irsan1805/projectGate-TLab-UMY/BOM Projek Magang TLab.xlsx

Sheet: gate
No. | Category | Name of Item | Spesification | Picture of Product | Link Marketplace | Quantity | Unit Price | Total Cost
1. | Power Supply | Hi-Link HLK-PM01 Modul Power Supply | Input AC 100-220V Output DC 5V 3W |  | https://www.tokopedia.com/fortunajogja/hi-link-hlk-pm01-modul-power-supply-input-ac-100-220v-output-dc-5v-3w | 1 | 37700.00 | 37700.00
2. | Cetak PCB | PCB | Ukuran: 7x13 cm Jumlah: 1 Layer: single Tipe: fr2 Mask atas: biru Mask bawah: biru Silkscreen: putih File: Software PCB Bentuk: kotak |  | https://www.tokopedia.com/raftech/jasa-cetak-pcb-general | 1 | 85000.00 | 85000.00
3. | Microcontroller | esp32-devkit | ESP32 ESP-32 Arduino WIFI BLUETOOTH IOT DEVELOPMENT BOARD - Micro USB |  | https://www.tokopedia.com/temins/esp32-esp-32-arduino-wifi-bluetooth-iot-development-board-micro-usb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 | 1 | 55000.00 | 55000.00
4. | Perangkat Elektronika Dasar | resistor | RESISTOR 2K2 OHM 2K2OHM 1/2 W (5pcs) |  | https://www.tokopedia.com/kranti6b/resistor-2k2-ohm-2k2ohm-1-2-w-5pcs?extParam=src%3Dshop%26whid%3D8676 | 5 | 600.00 | 3000.00
 |  |  | RESISTOR 330 OHM 1/2 W (5pcs) |  | https://www.tokopedia.com/kranti6b/resistor-330-ohm-12-w?extParam=src%3Dshop%26whid%3D8676 | 5 | 600.00 | 3000.00
 |  |  | RESISTOR 220 OHM 1/2 W (5pcs) |  | https://www.tokopedia.com/kranti6b/resistor-220-ohm-12w-5pcs?extParam=src%3Dshop%26whid%3D8676 | 5 | 600.00 | 3000.00
 |  | PC817 |  |  | https://www.tokopedia.com/sarahelektronik/pc817-sharp-pc-817?extParam=ivf%3Dfalse&src=topads | 6 | 550.00 | 3300.00
 |  | Dioda Silicon 1N4007 | Dioda Silicon 1N4007 1 Ampere |  | https://www.tokopedia.com/lunaelec/dioda-silicon-1n4007-in4007?extParam=ivf%3Dfalse&src=topads | 10 | 250.00 | 2500.00
 |  | TIP41 |  |  | https://www.tokopedia.com/kranti6b/tip41-tip-41?extParam=src%3Dshop%26whid%3D8676 | 7 | 1800.00 | 12600.00
 |  | Relay 5v HKE HRS2H 8 pin kaki HRS2H-S-DC5V | Relay HKE tipe HRS2H 8pin - 5VDC size : P = 20mm L = 10mm T = 11mm Operating voltage = 5V Max. Current = 2A |  | https://www.tokopedia.com/dx-tronics/relay-5v-hke-hrs2h-8-pin-kaki-hrs2h-s-dc5v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 (https://www.tokopedia.com/arduinomega/relay-5v-10a-songle-srd-05vdc-sl-c-5pin-dc-5-kaki) | 8 | 5350.00 | 42800.00
 |  | Terminal PCB | Terminal Block Konektor 5mm - 3 PIN |  | https://www.tokopedia.com/hayashiindonesia/terminal-blok-block-2-3-pin-skrup-screw-pcb-pitch-5mm-kabel-konektor-2-pin-hijau-tanpa-bubble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 | 8 | 620.00 | 4960.00
 |  | Terminal PCB | Terminal Block Konektor 5mm - 2 PIN |  | https://www.tokopedia.com/hayashiindonesia/terminal-blok-block-2-3-pin-skrup-screw-pcb-pitch-5mm-kabel-konektor-2-pin-hijau-tanpa-bubble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 (https://www.tokopedia.com/tokorudz/terminal-pcb-terminal-block-konektor-5mm-2-pin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) | 8 | 445.00 | 3560.00
 |  | LED | Led 3mm Hijau |  | https://www.tokopedia.com/kranti6b/led-3mm-hijau?extParam=src%3Dshop%26whid%3D8676 | 10 | 300.00 | 3000.00
Total Project Cost |  |  |  |  |  |  |  | 259420.00

Sheet: Face Recognition
No. | Category | Name of Item | Spesification | Picture of Product | Link Marketplace | Quantity | Unit Price | Total Cost
1. | Mini PC | NVIDIA JETSON NANO DEVELOVER KIT 4GB - B01 | GPU: 128-core Maxwell CPU:Quad-core ARM A57 @ 1.43 GHz RAM: 4 GB 64-bit LPDDR4 25.6 GB/s Penyimpanan Eksternal: microSD (not included) Video Encoder: 4K @ 30 | 4x 1080p @ 30 | 9x 720p @ 30 (H.264/H.265) Video Decoder: 4K @ 60 | 2x 4K @ 30 | 8x 1080p @ 30 | 18x 720p @ 30|(H.264/H.265) Soket Kamera: 2x MIPI CSI-2 DPHY lanes Konektifitas: Gigabit Ethernet, M.2 Key E Display Output: HDMI 2.0 and eDP 1.4 USB: 4x USB 3.0, USB 2.0 Micro-B Antarmuka: GPIO, I2C, I2S, SPI, UART Dimensi: 100x80x29mm |  | https://www.tokopedia.com/mycomshop/nvidia-jetson-nano-develover-kit-4gb-b01 | 1 | 5500000.00 | 5500000.00
 | Kamera | HIKVISION IP CAMERA 6MP DS-2CD2063G2-IU OUTDOOR Built-in Microphone | 1/2.8" Progressive Scan CMOS - H.265+/H.265/H.264+/H.264/MJPEG; - Powered by Darkfighter technology - Color: 0.005 lux@(F1.6, AGC ON), 0 lux with IR; - 20fps(3200x1800), 25fps/30fps (2688×1520, 1920×1080) - VCA functions; 3 streams - 3D DNR - BLC/HLC - ICR - EXIR, up to 40m - DC12V&PoE - Built-in micro SD/SDHC/SDXC slot - HIK-Connect cloud service; - U: built-in microphone |  | https://www.tokopedia.com/hikvisionid/hikvision-ip-camera-6mp-ds-2cd2063g2-iu-outdoor-built-in-microphone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 | 1 | 1823129.00 | 1823129.00
 | Power Supply | CCTV Power Supply 12V 5A / PSU Jaring 5 Ampere AC DC Switching Power | CCTV Power Supply 12V 5A / PS Jaring 5 Ampere Type : LED Power Supply, CCTV Power Supply , Camera Power Supply ; Input /AC : 110/220Vac ( ±15% ) ; 50/60Hz Output /DC : 12V*5A Application : This power supply is widely used in LED Decoration / Illumination Engineering / LED Advertising / Communication Equipment / CCTV System |  | https://www.tokopedia.com/stationofficial/cctv-power-supply-12v-5a-psu-jaring-5-ampere-ac-dc-switching-power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 | 1 | 39000.00 | 39000.00
Total Project Cost |  |  |  |  |  |  |  | 7362129.00
