irsan1805/projectGate-TLab-UMY/projectGATE/pdf/projectGATE-B_Cu.pdf

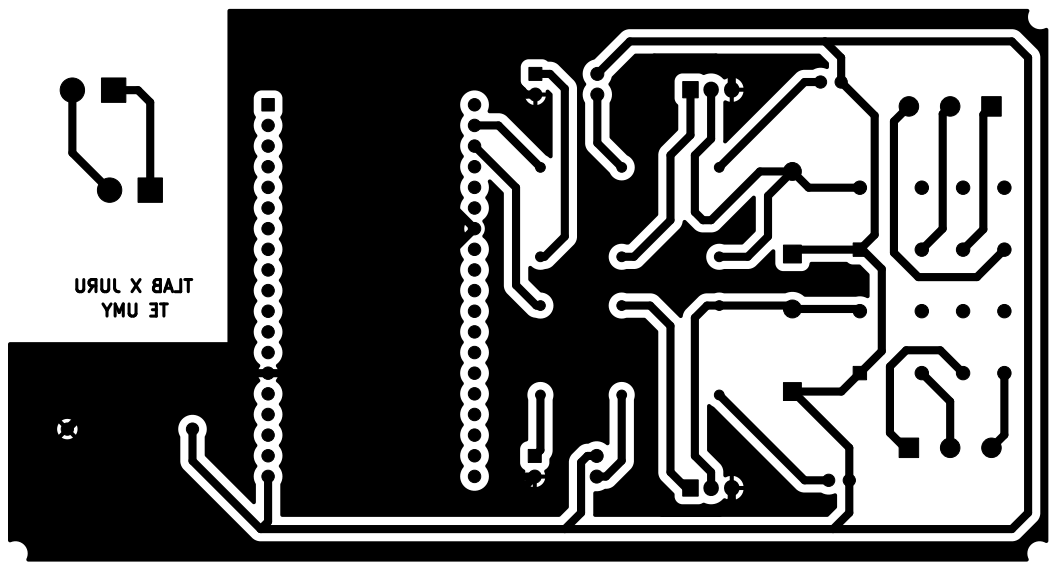
[picture p8: page 1]
