irsan1805/projectGate-TLab-UMY/projectGATE/pdf/projectGATE-B_Mask.pdf

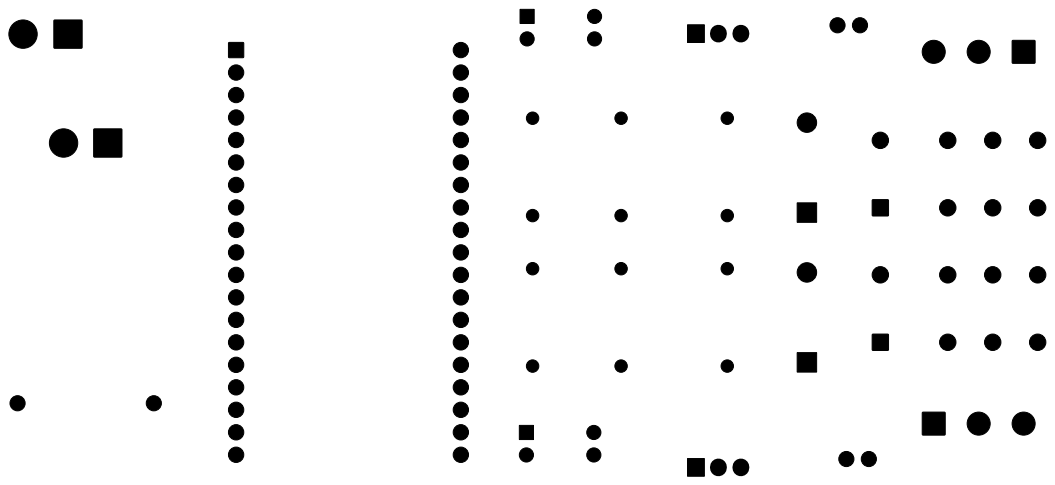
[picture p9: page 1]
