irsan1805/projectGate-TLab-UMY/projectGATE/pdf/projectGATE-Edge_Cuts.pdf

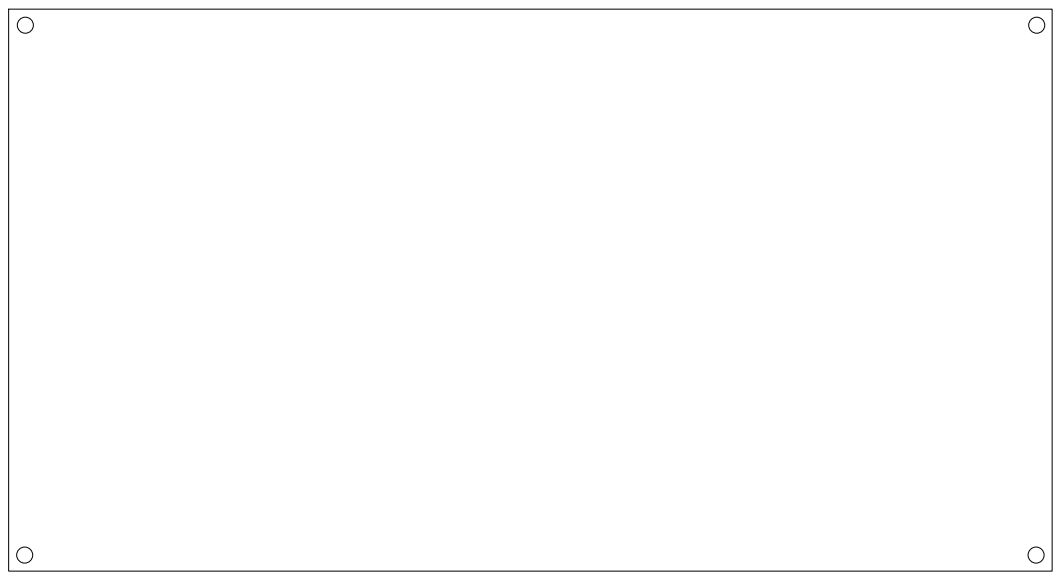
[picture p10: page 1]
