irsan1805/projectGate-TLab-UMY/projectGATE/pdf/projectGATE-F_Silkscreen.pdf

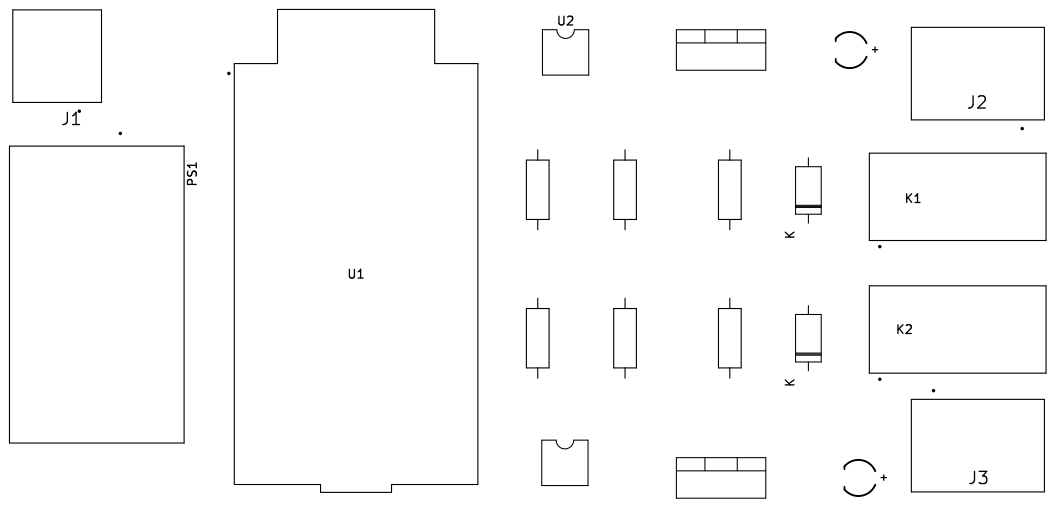
[picture p11: page 1]
