irsan1805/projectGate-TLab-UMY/projectGATE/projectGATE.kicad_pcb

## KiCad design projectGATE/projectGATE.kicad_pcb (2024-11-14)

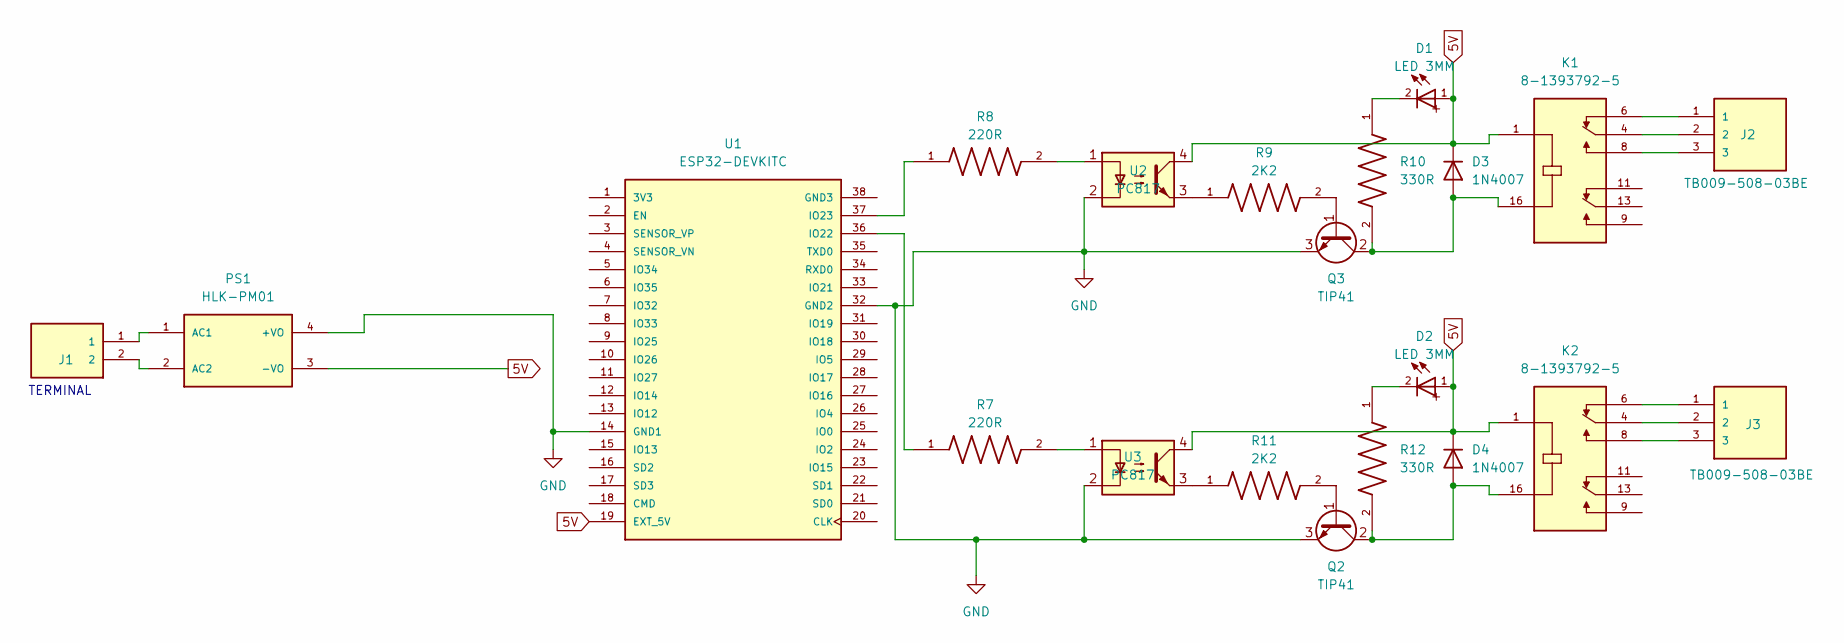
[picture p12: schematic projectGATE.kicad_sch]

Parts:
D1, D2: LED 3MM; WL-TMRC_3MM
D3, D4: 1N4007; D_DO-41_SOD81_P10.16mm_Horizontal
J1: TB009-508-02BE; CUI_TB009-508-02BE
J2, J3: TB009-508-03BE; CUI_TB009-508-03BE
K1, K2: 8-1393792-5; RELAY_8-1393792-5; PARTREV 1017
PS1: HLK-PM01; CONV_HLK-PM01
Q2, Q3: TIP41; TO-220-3_Vertical
R7, R8: 220R; RESAD1100W55L680D260; PARTREV 201304
R9, R11: 2K2; RESAD1100W55L680D260; PARTREV 201304
R10, R12: 330R; RESAD1100W55L680D260; PARTREV 201304
U1: ESP32-DEVKITC; MODULE_ESP32-DEVKITC; PARTREV N/A
U2, U3: PC817; DIP-4_W7.62mm

Connections:
5V: D1.1, D2.1, D3.1 (K), D4.1 (K), K1.1, K2.1, PS1.3 (-VO), U1.19 (EXT_5V), U2.4, U3.4
GND: PS1.4 (+VO), Q2.3 (E), Q3.3 (E), U1.14 (GND1), U1.32 (GND2), U2.2, U3.2
unnamed: D1.2, R10.1
unnamed: D2.2, R12.1
unnamed: D3.2 (A), K1.16, Q3.2 (C), R10.2
unnamed: D4.2 (A), K2.16, Q2.2 (C), R12.2
unnamed: J2.1, K1.6
unnamed: J2.2, K1.4
unnamed: J2.3, K1.8
unnamed: J3.1, K2.6
unnamed: J3.2, K2.4
unnamed: J3.3, K2.8
unnamed: J1.1, PS1.1 (AC1)
unnamed: J1.2, PS1.2 (AC2)
unnamed: Q2.1 (B), R11.2
unnamed: Q3.1 (B), R9.2
unnamed: R7.2, U3.1
unnamed: R8.2, U2.1
unnamed: R9.1, U2.3
unnamed: R11.1, U3.3
unnamed: R7.1, U1.36 (IO22)
unnamed: R8.1, U1.37 (IO23)

Notes on the sheet:
TERMINAL

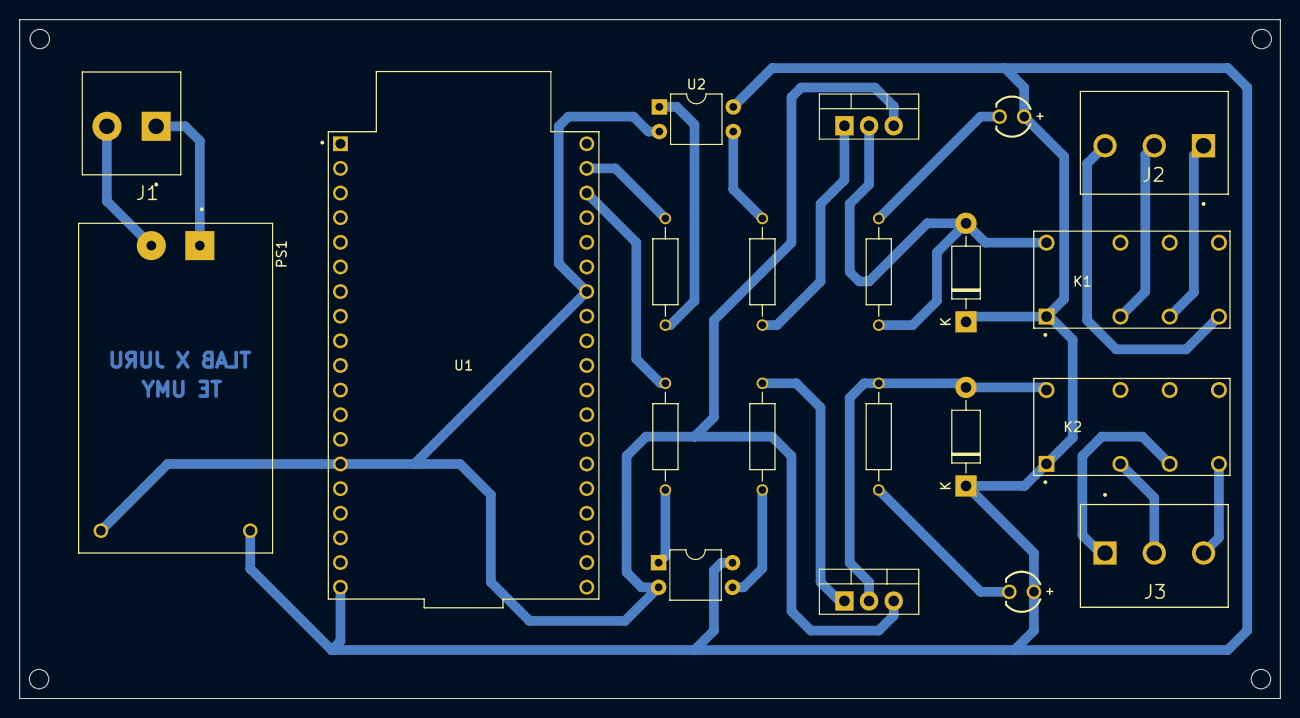
[picture p13: board projectGATE.kicad_pcb from above]

Board: 2 copper layers, 130.0 x 70.0 mm, 21 parts (0 on the bottom side), 22 nets.
