irsan1805/projectGate-TLab-UMY/(commit log)

2024-10-28 Menambahkan Schematic dan desain PCB
    [projectGATE.kicad_pcb, projectGATE.kicad_sch]
2024-11-14 menambahkan code untuk ESP32
    [projectGATE.kicad_pcb]
